hafuli123/AcGun-CardReader-File/硬件/读卡器BOM表.xlsx

No. | Quantity | Device | Designator | Footprint | Value
1 | 8 | 0603B104K101CT | C1,C6,C10,C13,C14,C15,C16,C17 | C0603 | 0.1uF
2 | 2 | 0603X475M160NT | C2,C11 | C0603 | 4.7uF
3 | 2 | 0603CG150J500NT | C3,C4 | C0603 | 15pF
4 | 3 | 0603CG220F500NT | C5,C7,C20 | C0603 | 22pF
5 | 1 | 0603B225K160CT | C8 | C0603 | 2.2uF
6 | 1 | 0603F105M250NT | C9 | C0603 | 1uF
7 | 3 | 0603X106M100CT | C12,C18,C19 | C0603 | 10uF
8 | 1 | HDGC2501WR-2P | CN1 | CONN-TH_2P-P2.50_HDGC2501WR-2P
9 | 1 | 1125-1104G0R138C002 | CN2 | HDR-TH_4P-P2.54-H-M-W9.4
10 | 1 | SS34_C8678 | D1 | DO-214AC_L4.3-W2.7-LS5.3-RD
11 | 2 | SS14A | D2,D3 | SMA_L4.3-W2.6-LS5.2-RD
12 | 1 | 2.2uh3a电感 | L2 | IND-SMD_L4.0-W4.0_0.47UH04209.5A | 2.2uH
13 | 1 | TLMG1100-GS08 | LED1 | 红色LED
14 | 1 | TLMG1100-GS08 | LED2 | 绿色LED
15 | 1 | TLMG1100-GS08 | LED3 | 黄色LED
16 | 1 | AO3401_C181091 | Q1 | SOT-23-3_L2.9-W1.3-P1.90-LS2.4-BR
17 | 2 | AO3400 | Q2,Q3 | SOT-23_L2.9-W1.3-P1.90-LS2.4-BR
18 | 3 | MCT06030C1003FP500 | R1,R13,R15 | R0603 | 100kΩ
19 | 4 | TR0603B1K00P0525Z | R2,R19,R20,R21 | R0603 | 1kΩ
20 | 6 | SY0603JN10KP | R3,R4,R5,R6,R8,R10 | R0603 | 10kΩ
21 | 1 | RMC 0603 4K7 F N | R7 | R0603 | 4.7kΩ
22 | 2 | RC0603DR-0720KL | R9,R17 | R0603 | 20kΩ
23 | 1 | 0603WAJ0302T5E | R11 | R0603 | 3kΩ
24 | 2 | AC0603FR-0730KL | R12,R18 | R0603 | 30kΩ
26 | 1 | RC0603FR-07453KL | R14 | R0603 | 453kΩ
29 | 2 | 按键开关 | SW1,SW2 | 按钮开关
30 | 1 | 1TS001G-2700-1500-CT | SW3 | SW-SMD_4P-L5.1-W5.1-P3.70-LS6.5-TL-2
31 | 1 | W25Q128JVSIQ | U1 | SOIC-8_L5.3-W5.3-P1.27-LS8.0-BL
32 | 1 | MFRC522mini | U2 | MFRC522mini
33 | 1 | STM32F401RCT6 | U3 | LQFP-64_L10.0-W10.0-P0.50-LS12.0-BL
34 | 1 | PW4056 | U4 | PW4056
35 | 1 | GC2400-TC010R | U5 | GC2400-TC010R
36 | 1 | PW2051 | U6 | PW2051
37 | 1 | TYPE-C 6P(073) | USB1 | TYPE-C-SMD_TYPE-C-6P
38 | 1 | 32.768KHz晶振 | Y1 | 3215
39 | 1 | 8MHz晶振 | Y2 | 5032
