hafuli123/AcGun-CardReader-File/(list of files, cad)

Other CAD files:
手册/MFRC-522 RC522 RFID射频 IC卡感应模块 送S50复旦卡/TJDZ-RC522射频卡用户使用手册资料Ver_1.0/51读写卡参考例程及上位机调试软件/51读写卡程序/MAIN.OBJ
手册/MFRC-522 RC522 RFID射频 IC卡感应模块 送S50复旦卡/TJDZ-RC522射频卡用户使用手册资料Ver_1.0/相关数据手册和参考文献/参考DEMO源代码/C51/MAIN.OBJ
手册/MFRC-522 RC522 RFID射频 IC卡感应模块 送S50复旦卡/TJDZ-RC522射频卡用户使用手册资料Ver_1.0/相关数据手册和参考文献/参考DEMO源代码/C51/RC522.OBJ
手册/MFRC-522 RC522 RFID射频 IC卡感应模块 送S50复旦卡/TJDZ-RC522射频卡用户使用手册资料Ver_1.0/51读写卡参考例程及上位机调试软件/51读写卡程序/RC522.OBJ
