hafuli123/AcGun-CardReader-File/硬件/读卡器电路原理图.pdf

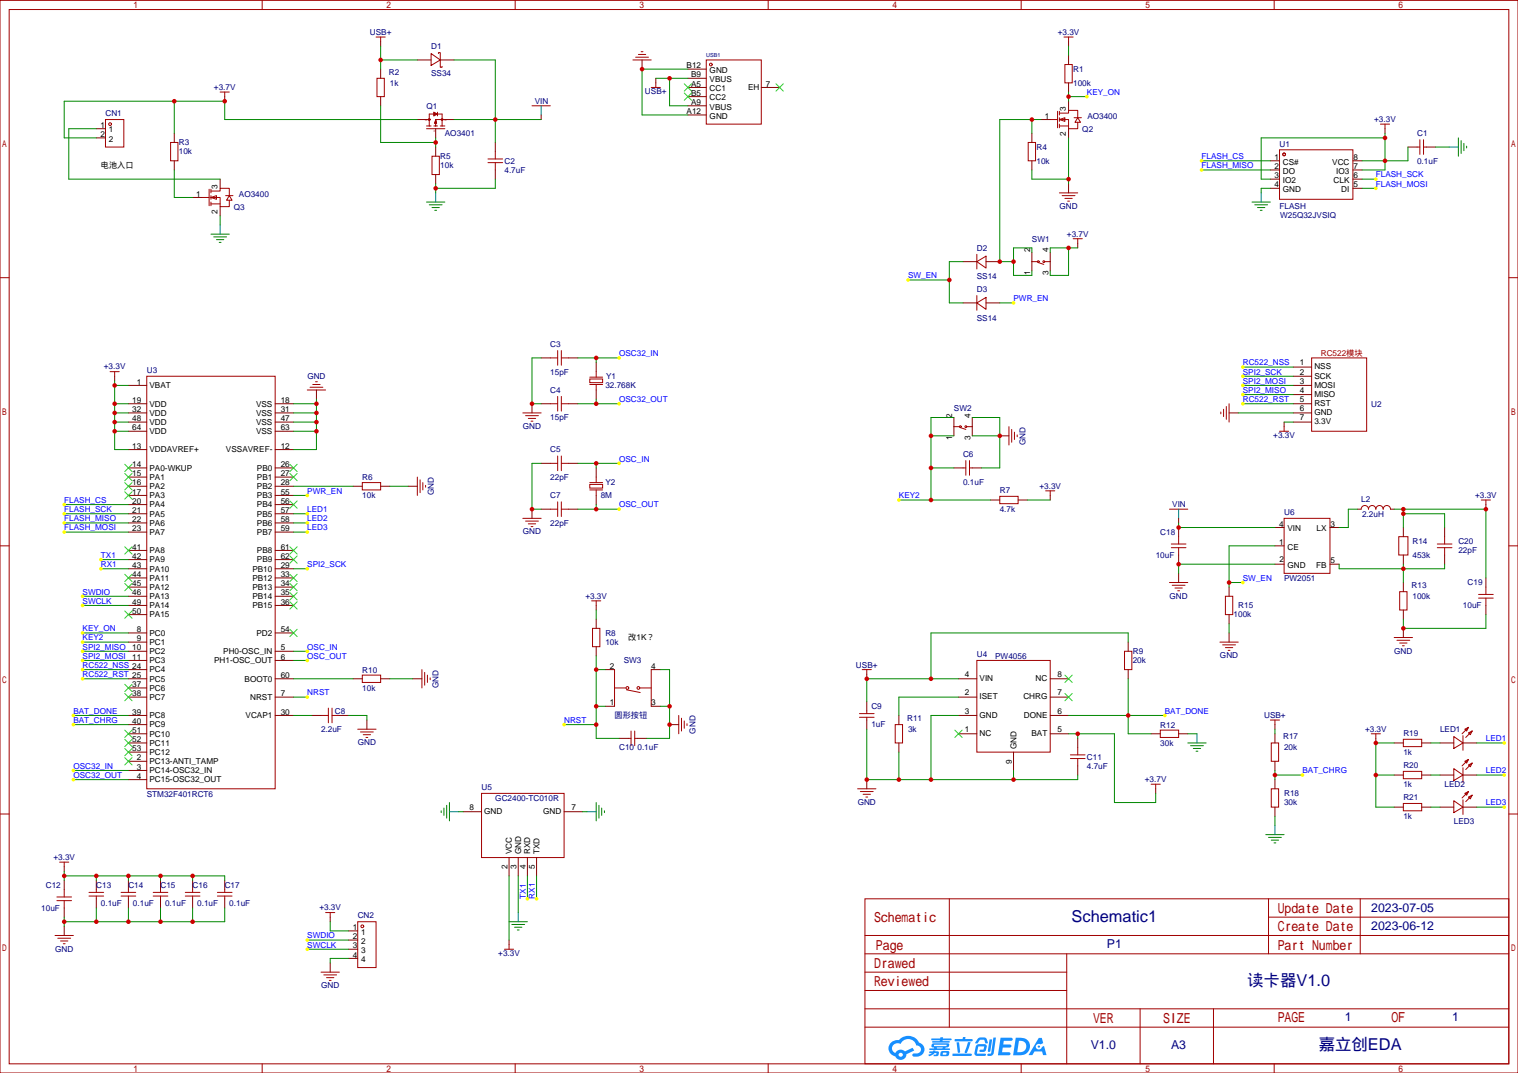
[picture p23: page 1]
