hafuli123/AcGun-CardReader-File/(list of files, drawings)

Other design files:
硬件/读卡器V1.0.eprj
