hafuli123/AcGun-CardReader-File/软件/写卡/rcc522writecard/Core/Src/main.c

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
/* Includes ------------------------------------------------------------------*/
#include "main.h"
#include "spi.h"
#include "gpio.h"

/* USER CODE BEGIN Includes */
#include "rc522_config.h"
#include "rc522_function.h"
/* USER CODE END Includes */


void SystemClock_Config(void);
/* USER CODE BEGIN PFP */
//uint8_t rc522_read(int fd,void*buf,int count);
/* USER CODE END PFP */

/* USER CODE BEGIN 0 */
uint8_t cardtype_temp[5] ,pTagType[2];
uint8_t apple ,writedone, step;
uint8_t rw_buf[]="testrc522";
uint8_t recv_buf[16];
char cStr [ 30 ];
uint8_t ucArray_ID [ 4 ];  //先后存放IC卡的UID(IC卡序列号)
uint8_t ucStatusReturn;          //返回状态	
uint8_t KEY_def[6]={0xff,0xff,0xff,0xff,0xff,0xff};
uint8_t KEY[6]={0xf5,0xfA,0xf0,0x00,0x88,0x18};	

	
uint8_t KEYCON[]={	0xff,0xff,0xff,0xff,0xff,0xff,
			0x08, 0x77, 0x8F, 0x69,
		0xf5,0xfA,0xf0,0x00,0x88,0x18	};
//块012 keyAB均可读，仅keyB可写。块3密码内容，keyA和keyB均不可读，只能用keyB写入。
//块3控制字节keyAB均可读，只有keyB可写。
	
		
#define     RECORD_ADDR     0x07    //记录信息的M1卡块地址
	uint8_t rc522_KeyB[6]={0xf5,0xfA,0xf0,0x00,0x88,0x18};  //B密码
		
	uint8_t ipmessage[16]={0};
/* USER CODE END 0 */

/**
  * @brief  The application entry point.
  * @retval int
  */
int main(void)
{
  /* MCU Configuration--------------------------------------------------------*/

  /* Reset of all peripherals, Initializes the Flash interface and the Systick. */
  HAL_Init();

  /* Configure the system clock */
  SystemClock_Config();

  /* Initialize all configured peripherals */
  MX_GPIO_Init();
  /* USER CODE BEGIN 2 */
	SPIx_Init();
	PcdReset();
	M500PcdConfigISOType ( 'A' );//设置工作方式
  /* USER CODE END 2 */

	uint16_t val;
	uint8_t *p,*d;
	val=0x0201;	//IP：0x信道PID  ，注意写入卡里的16字节数组为{0xaa, 0xPID, 0x信道, 和校验 , .. 0x00}
	d=(uint8_t*)&val;
	
	p=ipmessage;
	*p=0xaa;
	*(p+1)=*d;
	*(p+2)=*(d+1);
	
  /* USER CODE BEGIN WHILE */
  while (1)
  {
		/* step 1*/
		/*
		if ( ( ucStatusReturn = PcdRequest ( PICC_REQALL, pTagType ) ) == MI_OK ){
			if ( PcdAnticoll ( ucArray_ID ) == MI_OK ){
				if(pTagType[0]==0x04){
					if(PcdSelect(ucArray_ID)== MI_OK ){	
							if(PcdAuthState ( 0x61, 0x07, KEY_def, ucArray_ID )== MI_OK){	
								if(apple==0){
									PcdWrite ( 0x07, KEYCON );
									apple=1;									
								}
							}						
					}
				}
			}
		}
		*/
		
		/* step 2*/
		/*
		if ( ( ucStatusReturn = PcdRequest ( PICC_REQALL, pTagType ) ) == MI_OK ){
			if ( PcdAnticoll ( ucArray_ID ) == MI_OK ){
				if(pTagType[0]==0x04){
					if(PcdSelect(ucArray_ID)== MI_OK ){	
							if(PcdAuthState ( 0x61, 0x05, KEY, ucArray_ID )== MI_OK){	
												apple=2;
												PcdRead ( 0x05, recv_buf);
												if(*recv_buf != 0xaa){
													PcdWrite ( 0x05, ipmessage );
													apple=3;
												}
							}						
					}
				}
			}
		}	
		*/
	
		
		HAL_Delay(500);

		
    /* USER CODE BEGIN 3 */
		
  }
  /* USER CODE END 3 */
}


/*
uint8_t rc522_read(int fd,void*buf,int count)
{
    //读内容
    uint8_t ucStatusReturn;
    uint8_t ucArray_ID[4];//存放序列号
    uint8_t pTagType[2];//卡类
    ucStatusReturn = PcdRequest ( PICC_REQALL, pTagType );
    if ( ucStatusReturn!= MI_OK ){
        return ucStatusReturn;
    }
    else if(ucStatusReturn== MI_OK){
        if(*pTagType!=0x04){ //不是M1卡
            return MI_ERR;
        }
        if ( PcdAnticoll ( ucArray_ID ) == MI_OK ){
            if(PcdSelect(ucArray_ID)== MI_OK ){
                if((PcdAuthState ( 0x61, RECORD_ADDR, rc522_KeyB, ucArray_ID )== MI_OK)&&(count==0)){
                    PcdRead ( RECORD_ADDR, buf);
                }
            }
        }
				return MI_OK; 
    }
		return MI_OK; 
}
*/
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
