hafuli123/AcGun-CardReader-File/软件/写卡/rcc522writecard/Core/Inc/main.h

#define RCC522_RST_Pin GPIO_PIN_3
#define RCC522_RST_GPIO_Port GPIOA
#define RCC522_NSS_Pin GPIO_PIN_4
#define RCC522_NSS_GPIO_Port GPIOA
