hafuli123/AcGun-CardReader-File/手册/MFRC-522 RC522 RFID射频 IC卡感应模块 送S50复旦卡/TJDZ-RC522射频卡用户使用手册资料Ver_1.0/MSP430F149读写卡参考例程/BoardConfig.h

#define uchar unsigned char
#define uint unsigned int 

//控制位的宏定义
#define Ctrl_Out  P3DIR |= BIT3 + BIT6 + BIT7;
#define Ctrl_0    P3OUT &= ~(BIT3 + BIT6 + BIT7)
#define SRCLK_1   P3OUT |= BIT7
#define SRCLK_0   P3OUT &= ~BIT7
#define SER_1     P3OUT |= BIT6
#define SER_0     P3OUT &= ~BIT6
#define RCLK_1    P3OUT |= BIT3
#define RCLK_0    P3OUT &= ~BIT3

//板上资源配置函数
void BoardConfig(uchar cmd)
{
    uchar i;
    
    Ctrl_Out;
    Ctrl_0;
    
    for(i = 0; i < 8; i++)
    {
        SRCLK_0;
        if(cmd & 0x80)  SER_1;
        else            SER_0;
        SRCLK_1;
        cmd <<= 1;
    }
    RCLK_1;
    _NOP();
    RCLK_0;
}
