hafuli123/AcGun-CardReader-File/软件/初始化无线模块/gc24init/Core/Inc/bsp_usartx.h

#ifndef __BSP_USARTX_H__
#define __BSP_USARTX_H__

/* 包含头文件 ----------------------------------------------------------------*/
#include "stm32f4xx_hal.h"

/* 类型定义 ------------------------------------------------------------------*/
/* 宏定义 --------------------------------------------------------------------*/

//读卡器
#define USARTx                                 USART1
#define USARTx_BAUDRATE                        9600
#define USART_RCC_CLK_ENABLE()                 __HAL_RCC_USART1_CLK_ENABLE()
#define USART_RCC_CLK_DISABLE()                __HAL_RCC_USART1_CLK_DISABLE()

#define USARTx_GPIO_ClK_ENABLE()               __HAL_RCC_GPIOA_CLK_ENABLE()
#define USARTx_Tx_GPIO_PIN                     GPIO_PIN_9
#define USARTx_Tx_GPIO                         GPIOA
#define USARTx_Rx_GPIO_PIN                     GPIO_PIN_10   
#define USARTx_Rx_GPIO                         GPIOA

#define USARTx_AFx                             GPIO_AF7_USART1

#define USARTx_IRQHANDLER                      USART1_IRQHandler
#define USARTx_IRQn                            USART1_IRQn


/* 扩展变量 ------------------------------------------------------------------*/
extern UART_HandleTypeDef husartx;

/* 函数声明 ------------------------------------------------------------------*/
void MX_USARTx_Init(void);


#endif  /* __BSP_USARTX_H__ */

/******************* (C) COPYRIGHT 2015-2020 硬石嵌入式开发团队 *****END OF FILE****/
