hafuli123/AcGun-CardReader-File/手册/MFRC-522 RC522 RFID射频 IC卡感应模块 送S50复旦卡/TJDZ-RC522射频卡用户使用手册资料Ver_1.0/相关数据手册和参考文献/参考DEMO源代码/C430/MAIN.H

#include  <msp430x41x.h>


/////////////////////////////////////////////////////////////////////
//端口定义
/////////////////////////////////////////////////////////////////////
#define NSS522_1       P1OUT |=  BIT7              
#define NSS522_0       P1OUT &=~ BIT7              
#define SCK522_1       P1OUT |=  BIT6              
#define SCK522_0       P1OUT &=~ BIT6              
#define SI522_1        P1OUT |=  BIT5           
#define SI522_0        P1OUT &=~ BIT5              
#define SO522          ((P1IN >> 4) & 0x01)              
#define RST522_1       P1OUT |=  BIT3        
#define RST522_0       P1OUT &=~ BIT3        

#define LED_GREEN_ON   P6OUT &=~  BIT3
#define LED_GREEN_OFF  P6OUT |= BIT3 

/////////////////////////////////////////////////////////////////////
//函数原型
/////////////////////////////////////////////////////////////////////
void InitializeSystem(void);                                   
void DelayMs(unsigned int _MS);                                      
