hafuli123/AcGun-CardReader-File/手册/MFRC-522 RC522 RFID射频 IC卡感应模块 送S50复旦卡/TJDZ-RC522射频卡用户使用手册资料Ver_1.0/相关数据手册和参考文献/参考DEMO源代码/C51/MAIN.H

//////////////////////////////////
//端口定义
/////////////////////////////////////////////////////////////////////
//MFRC500
sbit     MF522_RST  =    P1^2;                   //RC500片选
sbit     MF522_NSS  =    P0^0;
sbit     MF522_SCK  =    P1^7;
sbit     MF522_SI   =    P1^6;
sbit     MF522_SO   =    P1^3;
//指示灯
sbit     LED_GREEN  =    P0^1;  
/////////////////////////////////////////////////////////////////////
//函数原型
/////////////////////////////////////////////////////////////////////
void InitializeSystem();                                   
                                    
