hafuli123/AcGun-CardReader-File/(notices)

Notices in the files:
软件/初始化无线模块/gc24init/Core/Inc/bsp_spiflash.h:
(C) COPYRIGHT 2015-2020 Ó²Ê¯Ç¶ÈëÊ½¿ª·¢ÍÅ¶Ó *****END OF FILE
